maruthirm333-prog/netra/NAVYANTRA_Abstract_NETRA_final.docx

# NAVYANTRA – BUILD BEYOND BOUNDARIES

24-Hour National-Level Hardware Hackathon

# ABSTRACT SUBMISSION TEMPLATE

Team Name: | Green Byte
Project Title: | NETRA - Networked Environmental Threat and Risk Alert System
Domain: | Disaster Management / Environmental Monitoring (Hardware IoT)

## TEAM MEMBERS

Sl. No. | Name | College / Institution | Email /Phone
1 | Maruthi R M | Malnad College of Engineering, Hassan | 9901138565
2 | N S Gagan | Malnad College of Engineering, Hassan | 7019516919
3 | Mohammed Farhan | Malnad College of Engineering, Hassan | 6363877090
4

## 1. Problem Statement (50-75 WORDS)

Floods, forest fires, frost and sudden air-quality events cause heavy losses to smallholder farmers and forest-edge communities across India. Existing warning services reach people through SMS, mobile applications or cloud dashboards, all of which assume cellular or internet coverage. Many of these villages and farms have neither. The result is a last-mile gap: the people most exposed to these hazards receive no usable warning before damage occurs.

## 2. Proposed Solution (100-150 WORDS)

NETRA is a solar-powered sensor node that watches several hazards at once and raises the alarm locally, without any internet connection. A field node carries six low-cost sensor modules measuring temperature, humidity, smoke, flame, air quality, water level and ground vibration. Every two seconds it sends one short reading by LoRa radio at 433 MHz to a gateway unit placed in the farmhouse. The gateway compares each reading against a baseline it learns automatically for that location, combines several sensors into a confidence score for each hazard, and raises an alert when a score crosses the set level. The alert appears on an LCD, sounds a buzzer, and plays a spoken warning in the local language, so it reaches a person who owns no smartphone. Every event is stored on an SD card with a real-time-clock timestamp. Cloud upload happens only when Wi-Fi is available.

## 3. Methodology / Working Principle (250-300 WORDS)

The system works in five stages: sense, transmit, decide, alert and record. Sensing: the node samples all sensors every two seconds. The ultrasonic water sensor takes three readings and uses the median, removing the occasional false echo. Vibration pulses are counted by an interrupt over a rolling sixty-second window rather than read as a single sample, so a brief knock is distinguished from continuous disturbance. Transmission: the readings are packed into one comma-separated record of about forty bytes and sent over LoRa at 433.92 MHz, inside the licence-exempt band, with transmit power held within the permitted limit. A packet counter is included so lost packets can be identified, and CRC is enabled so a corrupted packet is discarded rather than read as a valid measurement. Decision: the gateway keeps the last ten readings of each variable and averages them to form a baseline for that site. This is why the same firmware works anywhere: a node placed near a persistent smoke source learns a high smoke baseline and reacts only to departures from it. Each new reading is converted into a score between zero and one, and several sensors are combined using fixed weights into a confidence percentage for each hazard. For fire, the flame sensor carries the largest weight, followed by smoke, temperature rise and humidity fall. The highest-scoring hazard raises an alert if it crosses the threshold. Baseline updating pauses during an alert, so a continuing event is not absorbed into normal. Alerting: the LCD names the hazard, the buzzer sounds and a recorded voice message plays in the local language. Recording: every reading and every alert is written to the SD card with a timestamp from the real-time clock, giving a local record that survives power loss and needs no connectivity.

## 4. Key Components / Technologies (100-125 WORDS)

Controllers: two ESP32 microcontroller boards, one for the field node and one for the gateway. Communication: SX1278 LoRa transceiver modules at 433.92 MHz with matched antennas. Sensors: DHT22 for temperature and humidity, MQ-2 for smoke and combustible gas, an infrared flame sensor, MQ-135 for air quality, JSN-SR04T waterproof ultrasonic sensor for water level, and SW-420 for vibration. Gateway output: 16x2 I2C LCD, piezo buzzer, ISD1820 voice playback module and speaker. Storage and timing: micro SD card module and DS3231 real-time clock. Power: 6 V solar panel, TP4056 charging module and an 18650 lithium-ion cell. Software: Arduino C++ firmware, ThingSpeak for optional cloud logging, and a browser-based map dashboard.

## 5. Expected Outcome (125 WORDS)

The prototype will demonstrate a complete warning chain working end to end without any internet connection: a hazard condition at the field node producing a spoken, audible and visual alert at the farmhouse within seconds. We expect to show detection of five hazard types on a single node, continuous unattended operation on solar power, and a stored event log with accurate timestamps that can serve as a local incident record. The system is intended to be duplicated rather than redesigned: adding a second node extends coverage using identical hardware. At an estimated cost of around five thousand rupees per node, the design targets farms and settlements that existing monitoring products do not reach, and offers a measurable alternative to having no warning at all.

## 6. Innovation / Unique Feature (100-150 WORDS)

Three things separate NETRA from the systems we studied. First, the entire alert path is offline: many comparable systems still depend on connectivity at the gateway, whereas NETRA decides and alerts locally and treats cloud upload as optional. Second, it combines five hazard types on one low-cost node, where existing products are specialists - one for fire, another for landslides - each priced well beyond a smallholder's reach. Third, the baseline is learned in place rather than fixed in code, so the same device adapts to a coalfield or a forest without reprogramming. We also chose weighted multi-sensor scoring rather than a trained model, because communities with no prior monitoring have no historical data to train on; this approach works from the first day of installation.
