maruthirm333-prog/netra/(commit log)

2026-08-23 feat: add NETRA product landing page
2026-08-23 feat: update landing page with latest version
2026-08-28 feat: Zone A full sensor suite — DHT22 + MQ2 + Flame + Vibration + Water level + LoRa
2026-08-28 docs: add sensor node README with pin map and packet format
2026-08-31 feat: Zone A full sensor firmware — DHT22 + MQ2 + Flame + Vibration + Water level + LoRa
    [zone_a_sensor_node.ino]
2026-08-31 docs: Zone A wiring table and packet format
2026-09-02 feat: update landing page — new version
2026-09-04 docs: add ThingSpeak fields, AI confidence scoring, pending hardware, flood sensor notes
2026-09-06 docs: SIH 2026 presentation guide — slide structure, content, checklist
2026-09-06 refactor: replace with clean commented version (proper section headers + inline docs)
    [zone_a_sensor_node.ino]
2026-09-06 cleanup: remove duplicate — clean version now in firmware/zone-a/
2026-09-06 cleanup: remove sensor-node folder — consolidated into firmware/zone-a/
2026-09-06 docs: full README overhaul — SIH 2026, dashboard link, packet format, firmware table, docs index
2026-09-06 assets: add NETRA Gateway Alert Unit CAD datasheet (NETRA-GW-001 Rev.A)
2026-09-06 assets: add NETRA Zone A Sensor Node CAD datasheet (NETRA-ZA-001 Rev.A)
